jacklzhu7/chipathon-2026-ppg/(commit log)

2026-07-11 Telescopic cascode and 2 stage Miller OTA
    [cascode.sch, cascode_cmfb.sch, two_stage_miller.sch]
2026-07-13 New progress on TIA and FDA Also created OTA symbols
    [cascode_cmfb_forsym.sch, cascode_cmfb_forsym_tb.sch, fda.sch, tia.sch, two_stage_miller_forsym.sch, two_stage_miller_forsym_tb.sch]
2026-07-13 Better organization with TIA/FDA folders
    [cascode.sch, cascode_cmfb.sch, cascode_cmfb_forsym.sch, cascode_cmfb_forsym_tb.sch, fda.sch, tia.sch, two_stage_miller.sch, two_stage_miller_forsym.sch]
2026-07-15 Add comparator schematic files
    [comp.sch, comp_annotation.sch, comparator_PVT.sch, comparator_plot.sch, comparator_sim.sch, comparator_sim_summary.sch, comparator_trans.sch]
2026-07-15 Changed topology to folded cascode in jz_fda2
    [cascode_cmfb_forsym_tb.sch, fda2.sch, foldedcasc.sch, foldedcasc_cmfb.sch, foldedcasc_cmfb_forsym.sch, foldedcasc_cmfb_forsym_tb.sch, tia.sch, two_stage_miller.sch]
2026-07-17 Add PPG filters (HPF/LPF/bandpass) and LED driver blocks schematics, symbols, testbenches, sim-verified
    [bandpass.sch, filters.sch, foldedcasc.sch, foldedcasc_cmfb.sch, foldedcasc_cmfb_forsym.sch, foldedcasc_cmfb_forsym_tb.sch, hpf.sch, led_driver.sch]
2026-07-17 Remove redundant testbenches and stale duplicate led_driver.sch
    [led_driver.sch]
2026-07-17 Remove stale single-ended passive filters.sch (superseded by differential FDA bandpass)
    [filters.sch]
2026-07-21 Added loop gain testbenches
    [fda2_loopgain_tb.sch, foldedcasc_cmfb_stab_tb.sch, tia.sch, tia_loopgain_tb.sch, two_stage_miller_forsym_tb.sch, two_stage_miller_larger.sch, two_stage_miller_larger_forsym.sch]
2026-07-21 comp symbol added
    [comp_forsym.sch]
2026-07-22 update pin names and add AC simulations
    [comparator_2_ac.sch]
2026-07-22 Trying the integration
    [comp_forsym.sch, foldedcasc_cmfb_forsym.sch, lpf.sch]
2026-07-22 Added toplevel schematic
    [toplevel.sch]
2026-07-22 Edited toplevel
    [comp_forsym.sch, toplevel.sch]
2026-07-22 Fixed comp_forsym.sch and edited toplevel
    [comp_forsym.sch, toplevel.sch]
2026-07-23 Redesign filters as 2nd-order active MFB biquads (HPF 0.1Hz, LPF 10Hz); remove bandpass top-level
    [bandpass.sch, hpf.sch, lpf.sch]
2026-07-23 Remove superseded Sallen-Key and Tow-Thomas explorations (MFB topology selected)
    [sk_filters.sch]
2026-07-23 New toplevel
    [tgate_switch.sch, tia.sch, toplevel2.sch]
2026-07-24 Updated toplevel
    [toplevel2.sch]
2026-07-29 add ibias pin
    [comp_forsym.sch]
2026-07-29 Add LED driver layout (folded NMOS current-set + switch, M2 combs, double guard ring); DRC+LVS clean. Fix gitignore to exclude generated netlists.
2026-08-03 Add bias current mirror: 5x Ibias25u + 1x Ibias5u, simple NMOS mirror, sim-verified
    [bias.sch]
2026-08-04 Bias: replace Rref resistor with reference NMOS (W=1u L=4.8u, g+d=VDD); all-transistor block for layout. Fix tb pin order.
    [bias.sch]
2026-08-05 Bias mirror layout: DRC clean + LVS match (fixed 5x device width bug)
2026-08-07 Latest toplevel schematic
    [fda2.sch, toplevel2.sch]
2026-08-14 unfinished layout folder uploaded, the latest one is coc.mag, sth is wrong with my connection I think, cuz all the nodes are shorted
    [coc.sch]
2026-08-14 finish the layout and lvs, update the shcematic and the matched symbol under the name of 'coc', run the simulaiton and it should be good to go
    [coc_forsym.sch, coc_sim.sch]
2026-08-18 Folded cascode layout
    [fda2.sch, fda2_loopgain_tb.sch, foldedcasc.sch, foldedcasc_cmfb.sch, foldedcasc_cmfb_forlayout.sch, foldedcasc_cmfb_forsym.sch, foldedcasc_cmfb_forsym_tb.sch, foldedcasc_cmfb_stab_tb.sch]
2026-08-19 TIA OTA layout
    [fda2.sch, fda2_loopgain_tb.sch, foldedcasc_cmfb_forlayout_tb.sch, tia.sch, tia_loopgain_tb.sch, two_stage_miller.sch, two_stage_miller_forsym.sch, two_stage_miller_forsym_tb.sch]
2026-08-23 Newest TIA/FDA layouts
    [fda2_forlayout.sch, tia.sch, tia_forlayout.sch, tia_loopgain_tb.sch, two_stage_miller_larger_forlayout.sch]
2026-09-02 New topcell schematic
    [B24_topcell.sch, fda2_forlayout.sch, jz_bias.sch, tia_forlayout.sch]
2026-09-02 Updated toplevel with bias
    [coc_forsym.sch, hpf.sch, jz_bias.sch, jz_bias_tb.sch, lpf.sch, toplevel2_withbias.sch]
2026-09-04 Integrated ibias with toplevel
    [coc_forsym.sch, fda2.sch, fda2_loopgain_tb.sch, foldedcasc_cmfb_forlayout.sch, foldedcasc_cmfb_forlayout_CMcheck.sch, foldedcasc_cmfb_forlayout_tb.sch, foldedcasc_cmfb_forsym_tb.sch, jz_bias.sch]
2026-09-07 Updated FDA sizing with larger L
    [fda2.sch, foldedcasc_cmfb_forlayout.sch, foldedcasc_cmfb_forlayout_CMcheck.sch, foldedcasc_cmfb_forlayout_tb.sch]
2026-09-10 PMOS mirror 5uA: DRC clean + LVS match (raw geometry, NCOMP tap, sim verified 5.04uA)
    [pmirror5u.sch]
2026-09-11 jz_bias layout: DRC clean + LVS match (9 devices, 2 PMOS + 7 NMOS, 57.2x12.5um)
2026-09-25 Update comparator simulation schematic
